BryceK111/MARS_Filament_Dryer/measurements.jpg

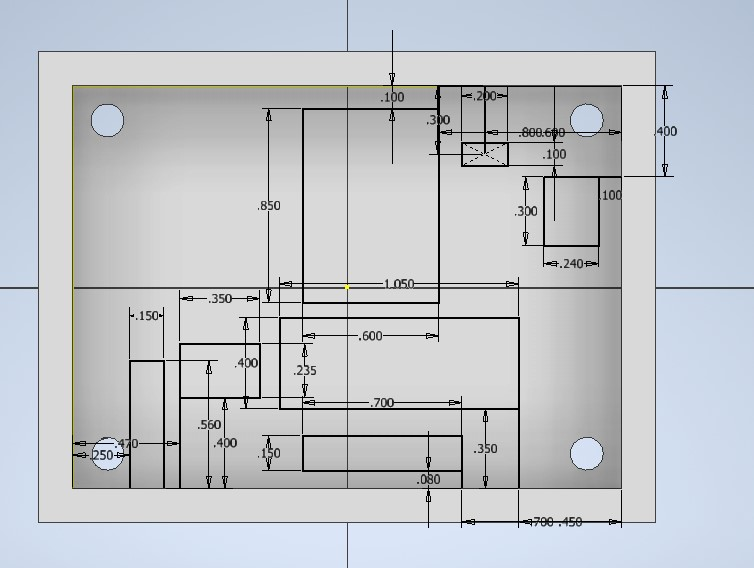
measurements.jpg
