BryceK111/MARS_Filament_Dryer/User Manual Files/Dryer_left.jpg

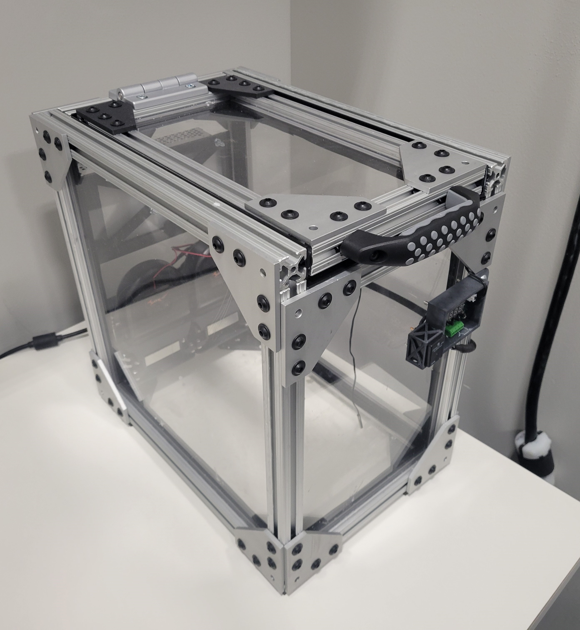
User Manual Files/Dryer_left.jpg
