BryceK111/MARS_Filament_Dryer/Filament_dryer.jpg

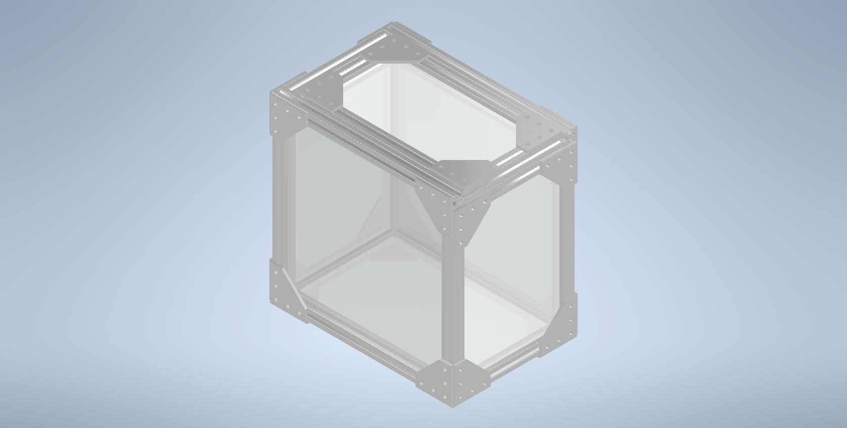
Filament_dryer.jpg
