BryceK111/MARS_Filament_Dryer/(list of files, cad)

Other CAD files:
12v_heater.ipt
12v_heater_mount.ipt
3136N434_Yellow.ipt
47065T267_T-Slotted Framing.ipt
47065T267_T-Slotted Framing_cut.ipt
Acrylic_sizing.ipt
Filament_dryer.iam
Power_Supply.ipt
T_slot_1in_12.35in.ipt
T_slot_1in_13.35in.ipt
T_slot_1in_15.35in.ipt
T_slot_1in_8.35in.ipt
T_slot_1in_8in.ipt
T_slot_1in_base.ipt
Thermostat_mount.ipt
corner_bracket.ipt
corner_bracket_flush.ipt
fan.ipt
panel_13x7.ipt
panel_13x9.ipt
panel_14x14.ipt
panel_14x9.ipt
