BryceK111/MARS_Filament_Dryer/User Manual Files/Filament Dryer User Manual.pdf

# Filament Dryer User Manual

## Contents

1 Safety Precautions | 2
2 Features and Design | 2
3 Recommended Drying Temperatures | 3
4 Operating Instructions | 3
5 Maintenance | 4
6 Troubleshooting | 5
7 Bill of Materials | 5
8 Technical Specifications | 5

## 1 Safety Precautions

- Do not exceed recommended temperatures for the filament you are drying (see Section 3 for details).
- Only dry one type of material at a time
- Always ensure the lid is securely closed before operating the dryer.
- Keep the dryer away from flammable materials.
- Ensure proper ventilation for the power supply.
- Avoid touching internal components while the dryer is in operation or immediately after use to prevent burns.

## 2 Features and Design

### 2.1 Physical Design

- Box Design: Made from t-slotted aluminum for the frame and acrylic sheets for the sides.
- Hinged Lid: The lid is gasket-sealed for an airtight fit, improving drying efficiency.
- Neoprene Foam: Lines the exposed t-slotted aluminum inside the box to enhance insulation and efficiency.

### 2.2 Heating System

- Two 12V heaters provide a combined heating capacity of up to 160W.
- Two 12V Fox-2 cooling fans ensure consistent airflow and even temperature distribution.

### 2.3 Power Supply

- An external 12V power supply delivers up to 180W to the system.

### 2.4 Temperature Control

- Controlled via an XH-W1219 thermostat module.
- Adjustable temperature settings with built-in hysteresis and safety alarms.

## 3 Recommended Drying Temperatures

Filament Type | Temperature Range (°C) | Drying Time
PLA | 40–50 | > 4h
PETG | 60–65 | > 2h
ABS | 65–75 | > 2h
Nylon | 75–90 | > 24h
Polycarbonate (PC) | 80–90 | > 6h
ASA | 80–85 | > 4h
TPU | 40–50 | > 4h
- Note: Drying times may vary depending on how long the material has been left in open air.
- It is recommended to do a test print after drying to ensure print quality.

## 4 Operating Instructions

### 4.1 Setup

1. Place the filament spool inside the box.
2. Close the lid and ensure the gaskets form a tight seal.

### 4.2 Powering On

1. Ensure the power supply is connected to the thermostat module.
2. Plug the power supply into an outlet. The thermostat and cooling fans will activate automatically.

### 4.3 Setting Temperature

1. Use the thermostat to set the desired drying temperature:
- Press SET to enter temperature setting mode.
- Use the + or - buttons to adjust the temperature.
- Press SET again to save the setting.

### 4.4 Monitoring Operation

- The thermostat displays the current temperature (top display) and the target temperature (bottom display).
- The relay activates the heaters when the temperature falls below the set point and deactivates them when the set point is reached.

### 4.5 Turning Off

1. Turn off the system by unplugging the power supply from its power outlet.
2. Do not touch the heating system until you are sure it has cooled off.

## 5 Maintenance

### 5.1 Cleaning

- Wipe down the acrylic sides and aluminum frame with a damp cloth as needed.
- Do not use abrasive cleaners or solvents.

### 5.2 Replacing Components

1. Relay Replacement:
- Desolder the damaged relay’s jumper wires and power terminals.
- Solder the new relay to the same connections.
2. Thermostat Replacement:
- Disconnect power leads from power connectors on the bottom of the board
- Disconnect temperature probe from the connector on the board
- Desolder jumper wires from relay to faulty thermostat
- Desolder original relay from new thermostat and solder the relay jumper wires in its place
- Connect temperature probe to the connector on the new board
- Connect power leads to the power connectors on the bottom of the board
3. Fan or Heater Replacement:
- Disconnect the faulty component.
- Install the replacement and reconnect wiring securely.

### 5.3 Sensor Calibration

- Use the thermostat’s P4 parameter to correct temperature readings as needed.

## 6 Troubleshooting

Issue | Possible Cause | Solution
Fans not running | Power supply issue | Check connections and power out-put.
Temperature not increasing | Heater or relay malfunc-tion | Inspect and replace components.
Incorrect temper-ature | Miscalibrated sensor | Adjust P4 parameter on the ther-mostat.

## 7 Bill of Materials

Component | Description | Link
12V Heaters (x2) | High-efficiency heaters | Amazon (https://amazon.com/gp/product/B081NZ6KLW)
12V Cooling Fans (x2) | Fox-2 Quiet chassis cooling fans | Amazon (https://www.amazon.com/CCBBAA-Computer-Chassis-Exhaust-Cooling/dp/B09BM2MSDF)
Power Supply | 12V, 180W power supply | Amazon (https://www.amazon.com/ALITOVE-Transformer-Switching-Converter-Security/dp/B078RZ6C3N?th=1)
High-Power Relay | Panasonic CB1AH-P-12V | DigiKey (https://www.digikey.com/en/products/detail/panasonic-electric-works/CB1AH-P-12V/1473541)
Thermostat | XH-W1219 temperature controller module | Amazon (https://www.amazon.com/gp/product/B07WLTR1R4?th=1)
Neoprene Insulation | Neoprene foam for insulation | Amazon (https://www.amazon.com/dp/B07WRMQ3BT?th=1)

## 8 Technical Specifications

- Temperature Range: 30°C to 110°C
- Power Supply: 12V DC, 180W max

– Heater Power Consumption: 157W

– Cooling Fan Power Consumption: 11W

– Thermostat Power Consumption: 1W

– Total Power Consumption: 169W

- Temperature Accuracy: ±0.1°C
- Relay Capacity: 14VDC @ 40A
