BryceK111/MARS_Filament_Dryer/User Manual Files/Cooling_Fan.jpg

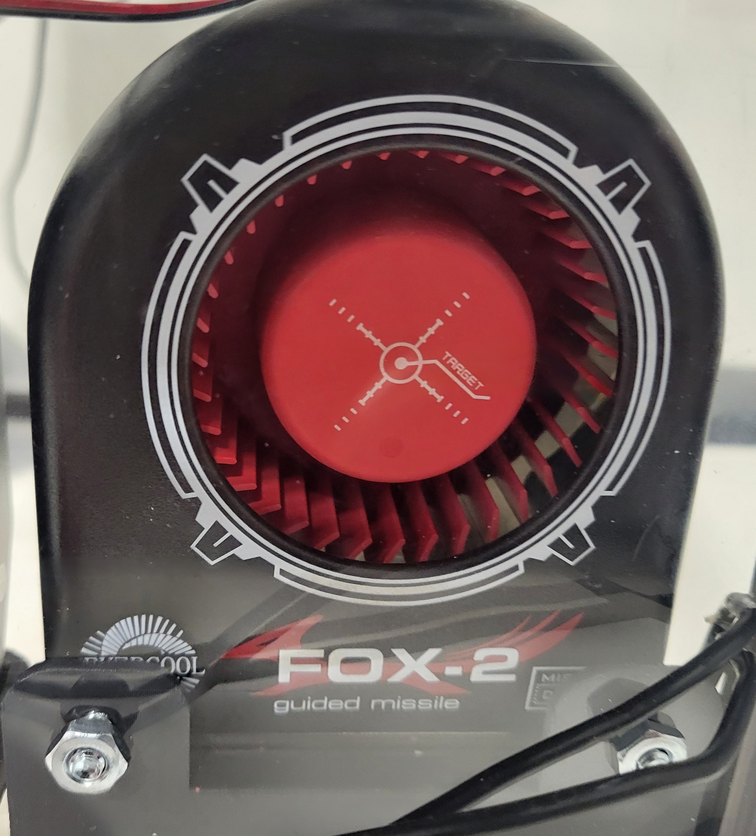
User Manual Files/Cooling_Fan.jpg
