BryceK111/MARS_Filament_Dryer/User Manual Files/Dryer_back.jpg

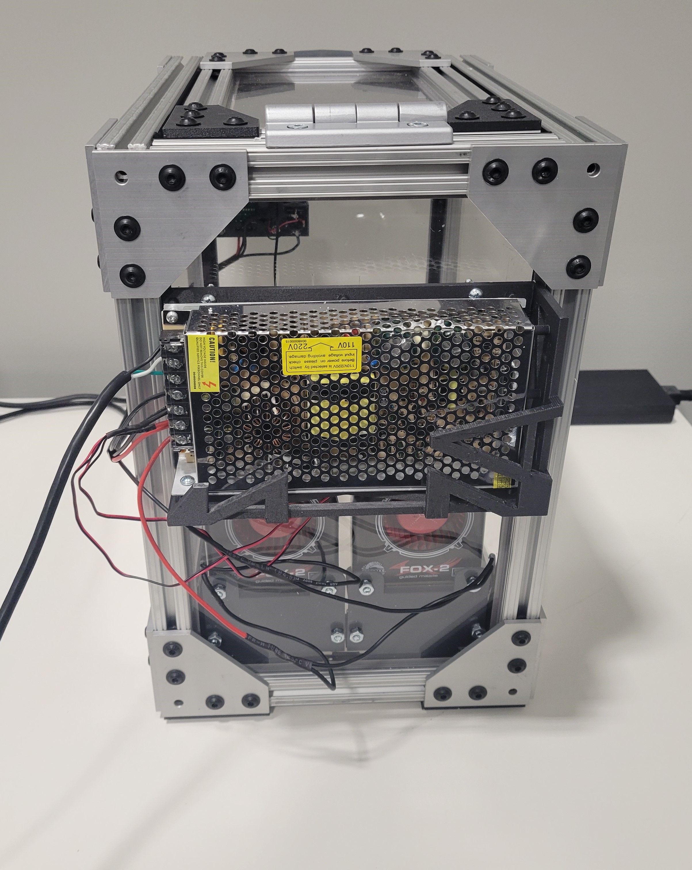
User Manual Files/Dryer_back.jpg
