BryceK111/MARS_Filament_Dryer/User Manual Files/Dryer_right.jpg

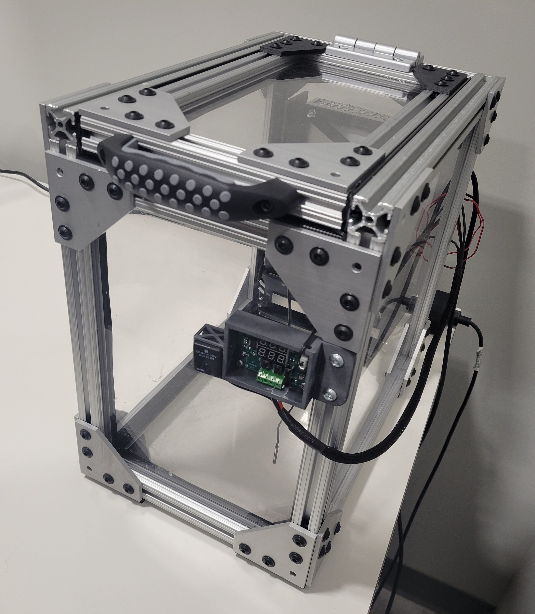
User Manual Files/Dryer_right.jpg
