BryceK111/MARS_Filament_Dryer/User Manual Files/Heater.jpg

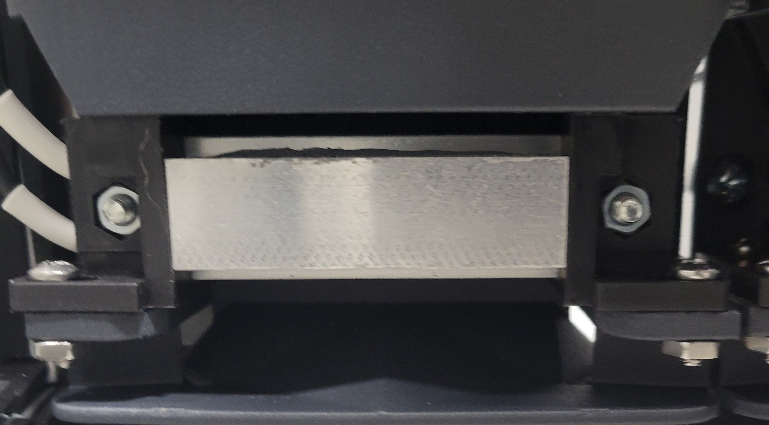
User Manual Files/Heater.jpg
