BryceK111/MARS_Filament_Dryer/User Manual Files/Lid.jpg

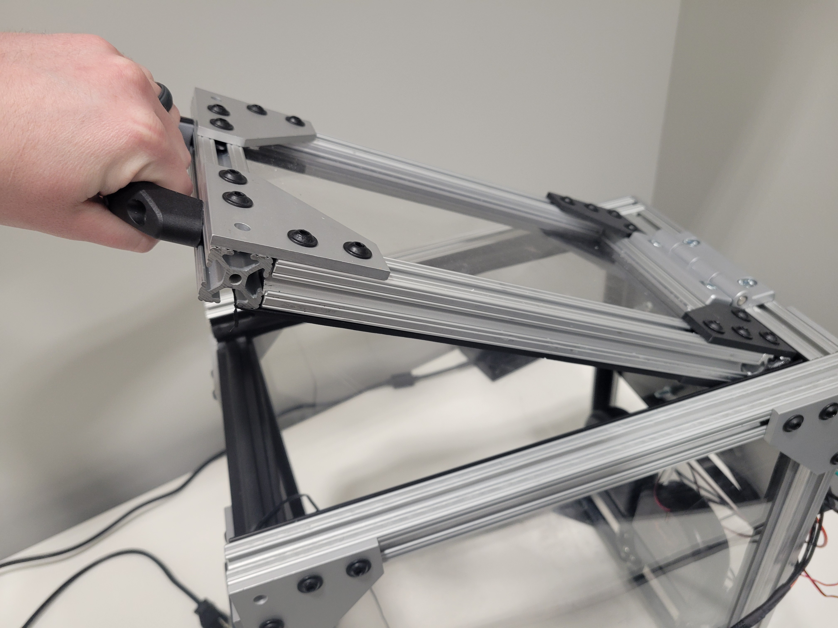
User Manual Files/Lid.jpg
