BryceK111/MARS_Filament_Dryer/User Manual Files/Power_Supply.jpg

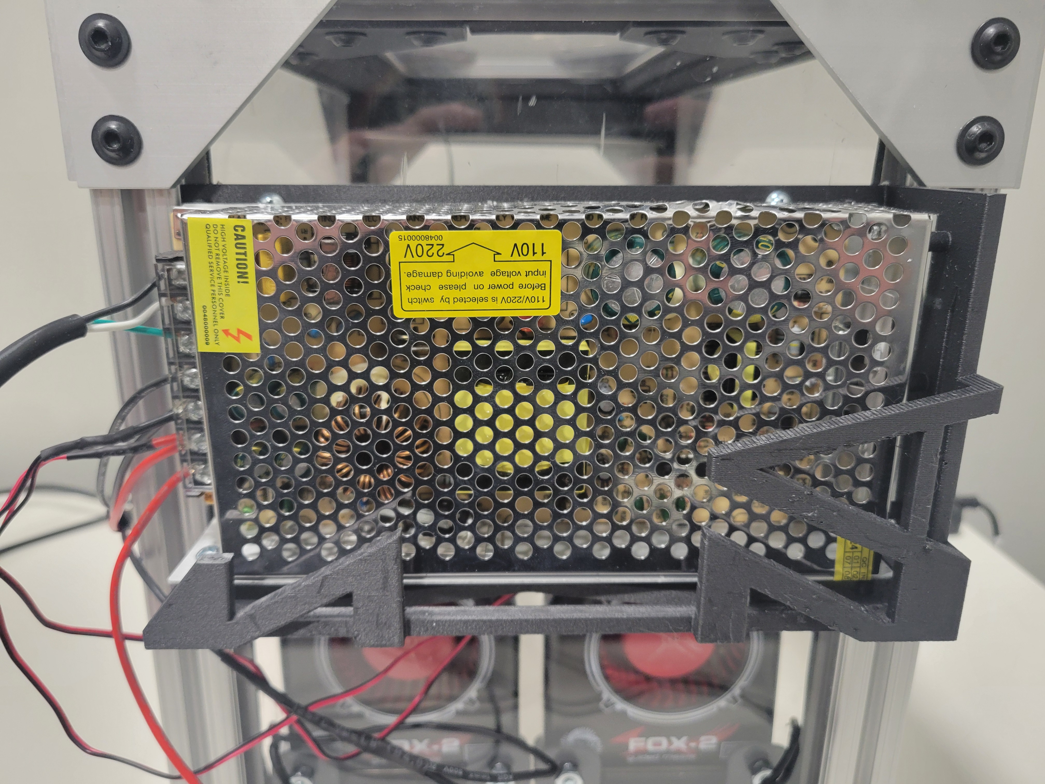
User Manual Files/Power_Supply.jpg
