BryceK111/MARS_Filament_Dryer/User Manual Files/Probe.jpg

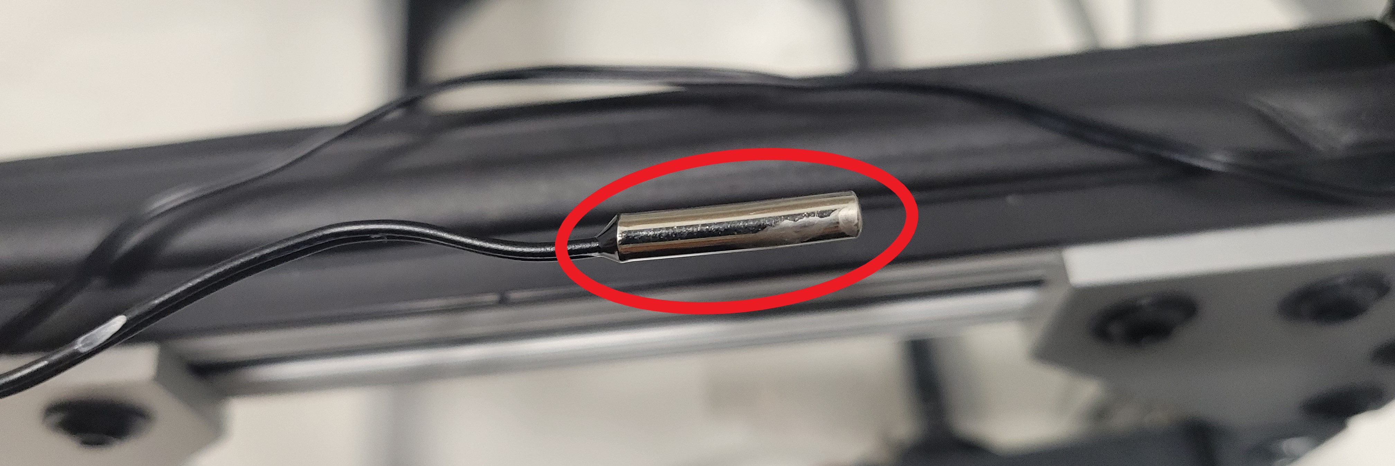
User Manual Files/Probe.jpg
