BryceK111/MARS_Filament_Dryer/User Manual Files/Probe_placement_above.jpg

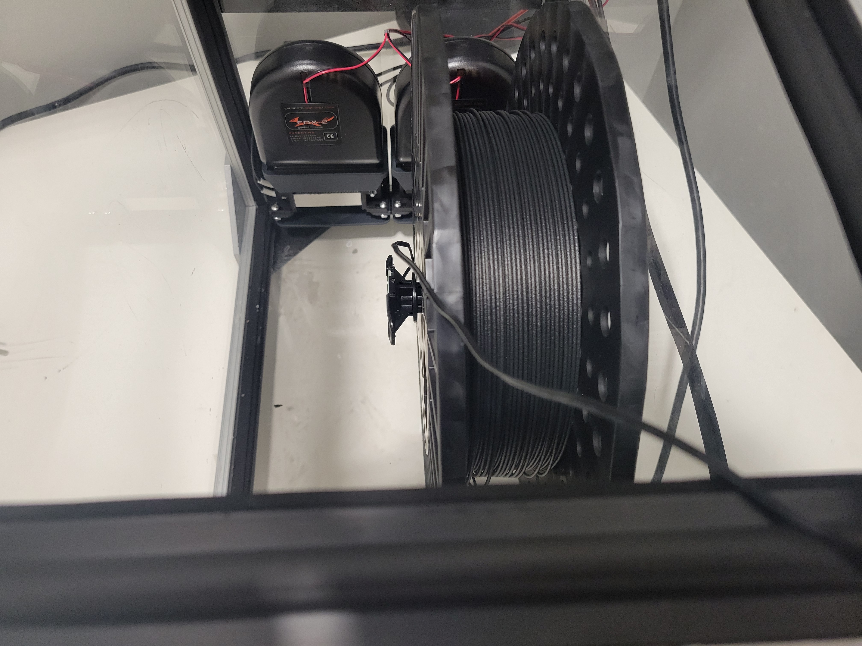
User Manual Files/Probe_placement_above.jpg
