BryceK111/MARS_Filament_Dryer/User Manual Files/Relay.jpg

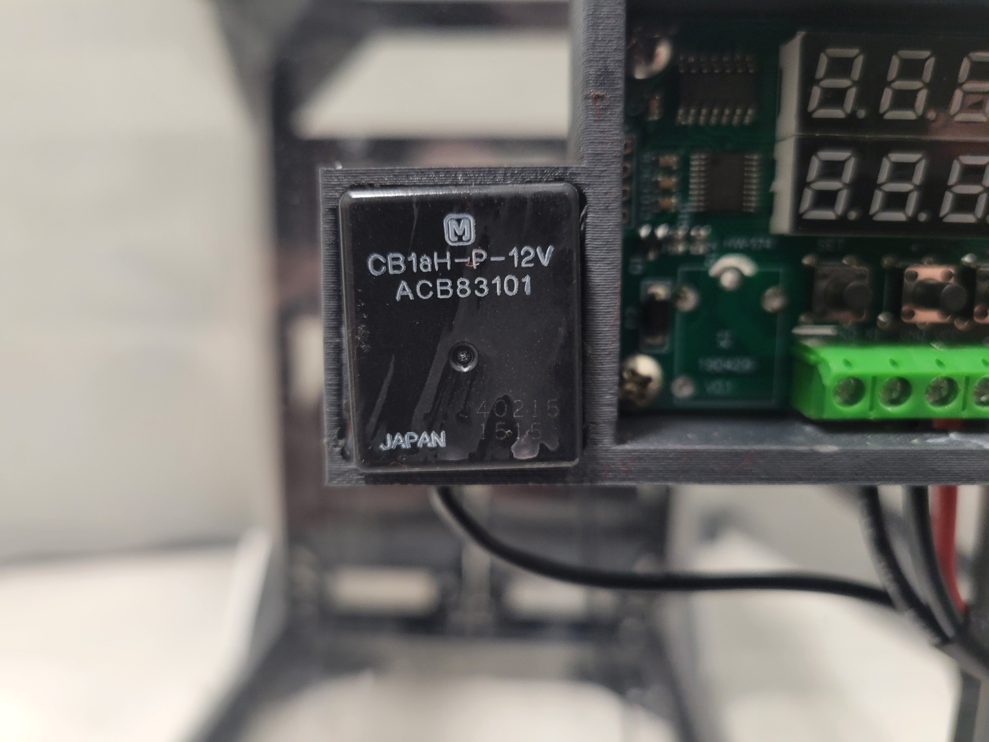
User Manual Files/Relay.jpg
