BryceK111/MARS_Filament_Dryer/User Manual Files/Relay_wiring.jpg

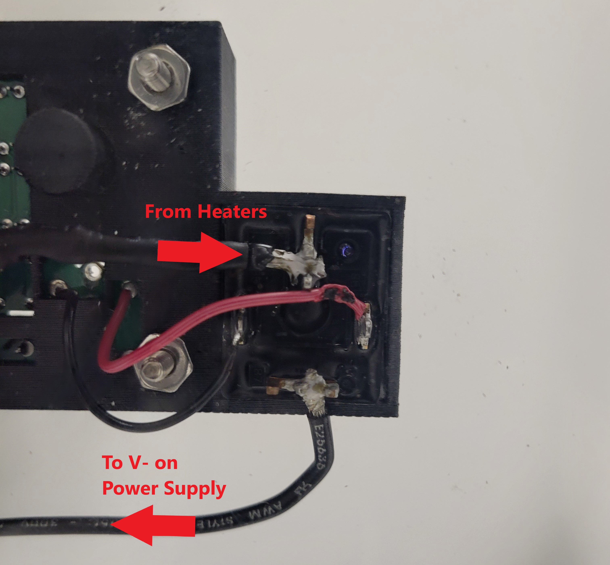
User Manual Files/Relay_wiring.jpg
