BryceK111/MARS_Filament_Dryer/User Manual Files/Thermostat info.jpg

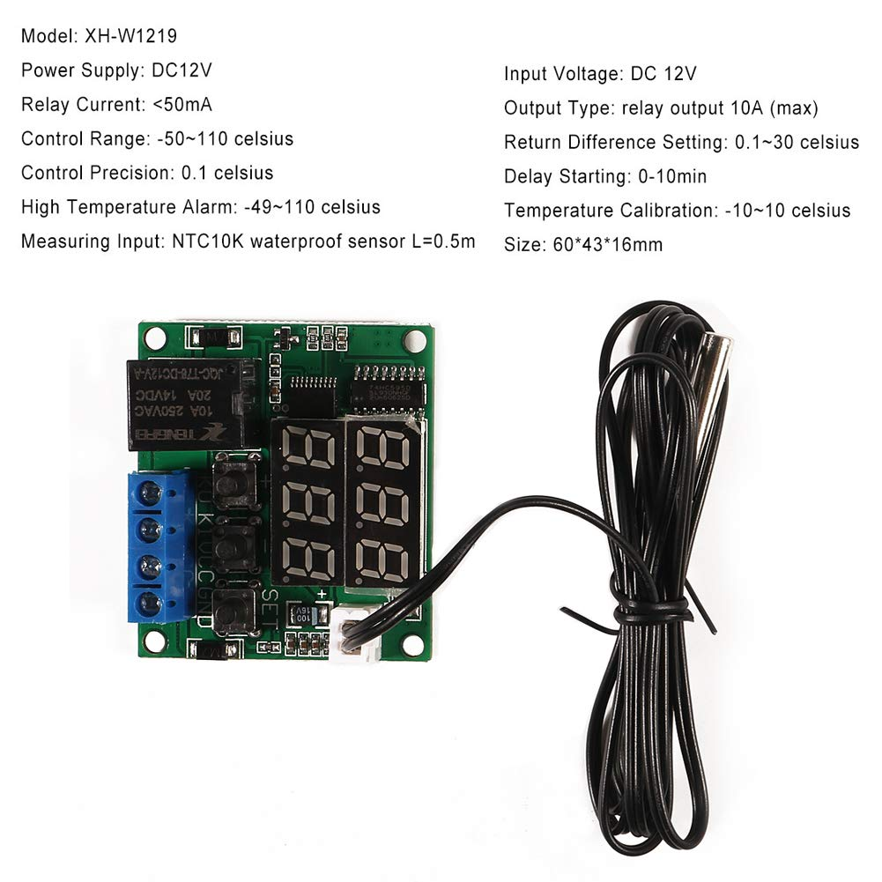
User Manual Files/Thermostat info.jpg
