BryceK111/MARS_Filament_Dryer/User Manual Files/Thermostat layout.jpg

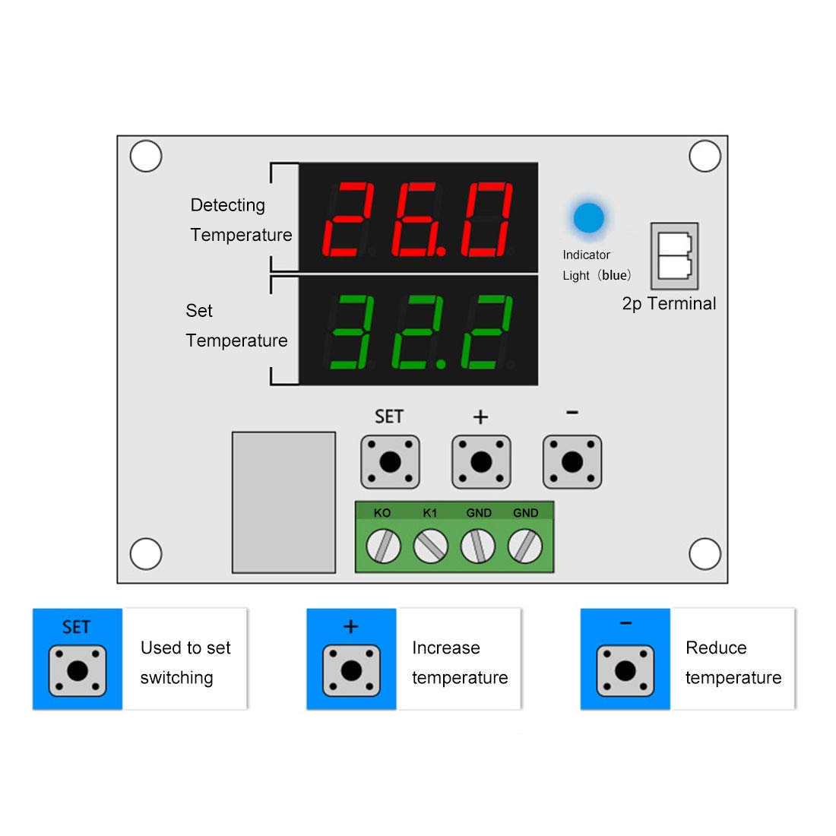
User Manual Files/Thermostat layout.jpg
