BryceK111/MARS_Filament_Dryer/User Manual Files/Thermostat Wiring Diagram.jpg

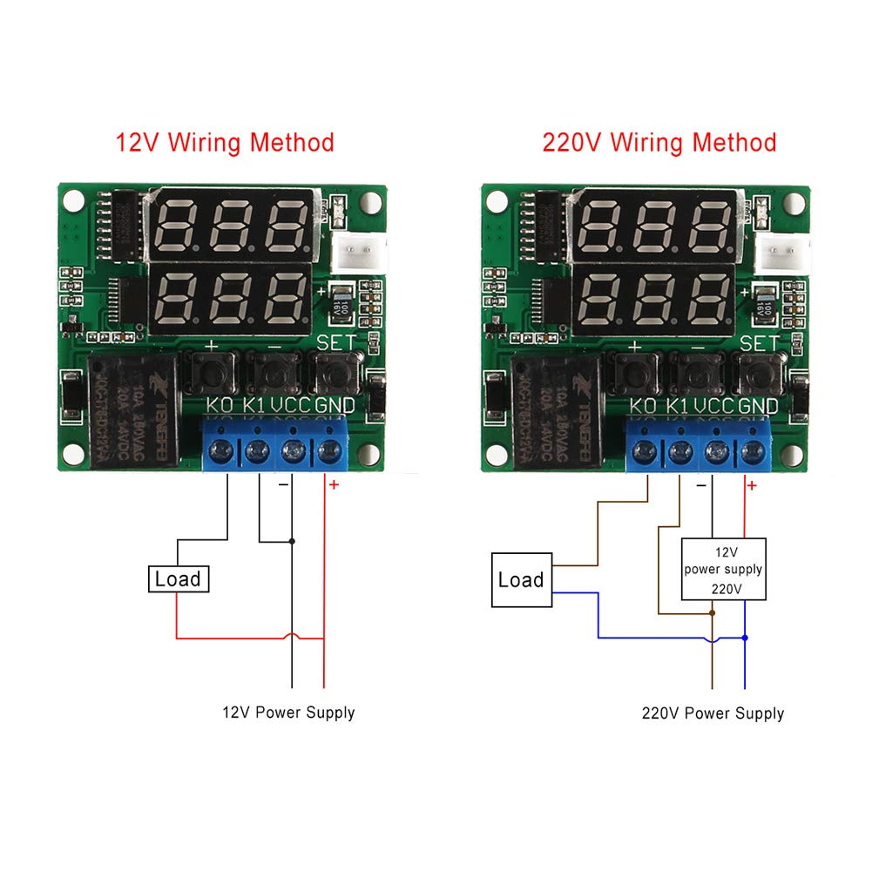
User Manual Files/Thermostat Wiring Diagram.jpg
