BryceK111/MARS_Filament_Dryer/User Manual Files/Thermostat.jpg

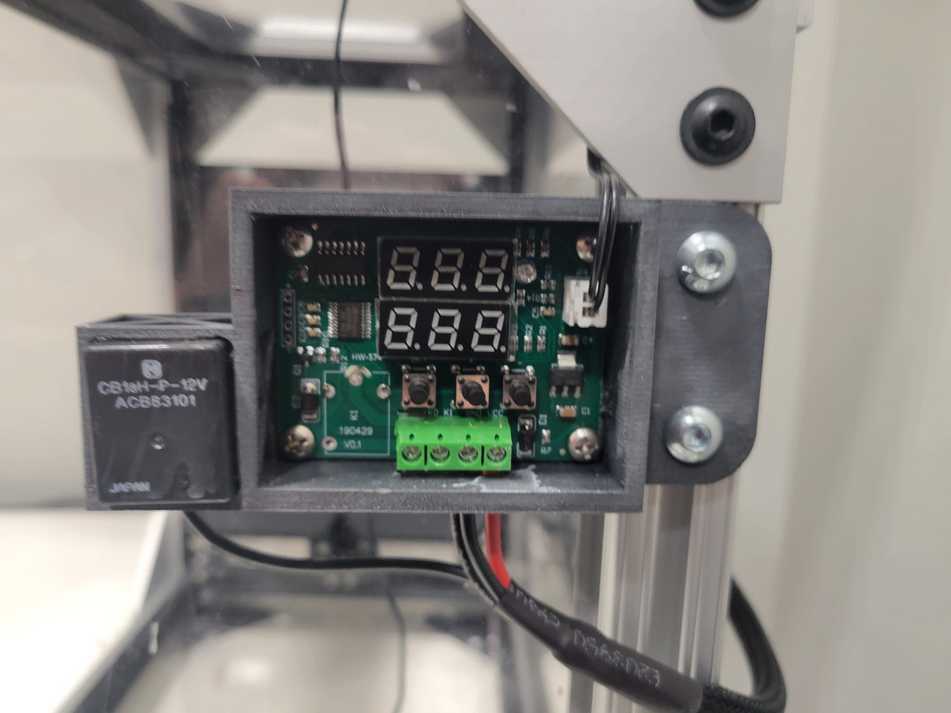
User Manual Files/Thermostat.jpg
