BryceK111/MARS_Filament_Dryer/User Manual Files/Thermostat_on.jpg

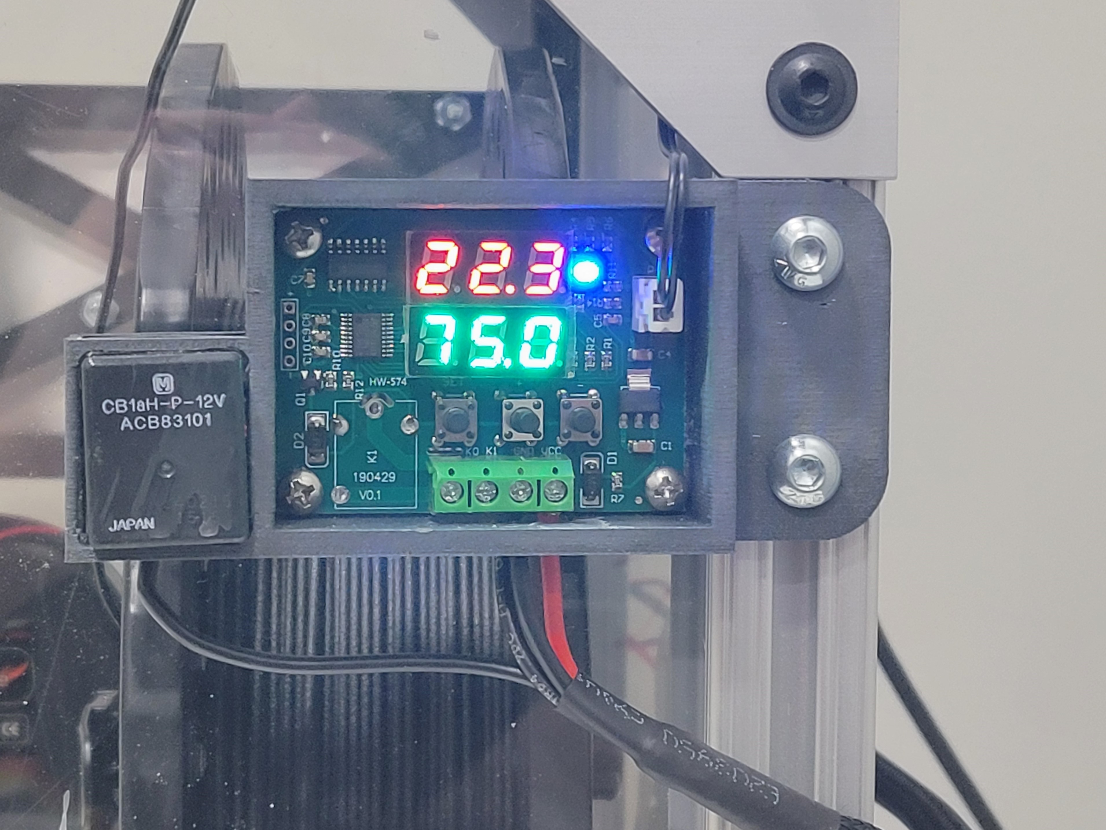
User Manual Files/Thermostat_on.jpg
